vsmaldino/arduinoenvmonitor/(commit log)

2019-12-25 Create arduinoenvmonitor.ino
    Versione iniziale
2020-01-19 Added OTA function, other minor improvements and more docs
    [cabling.xls]
